Ringel/ESP32Controller/esp32controller.kicad_pcb

## KiCad design esp32controller.kicad_pcb (2019-06-16)

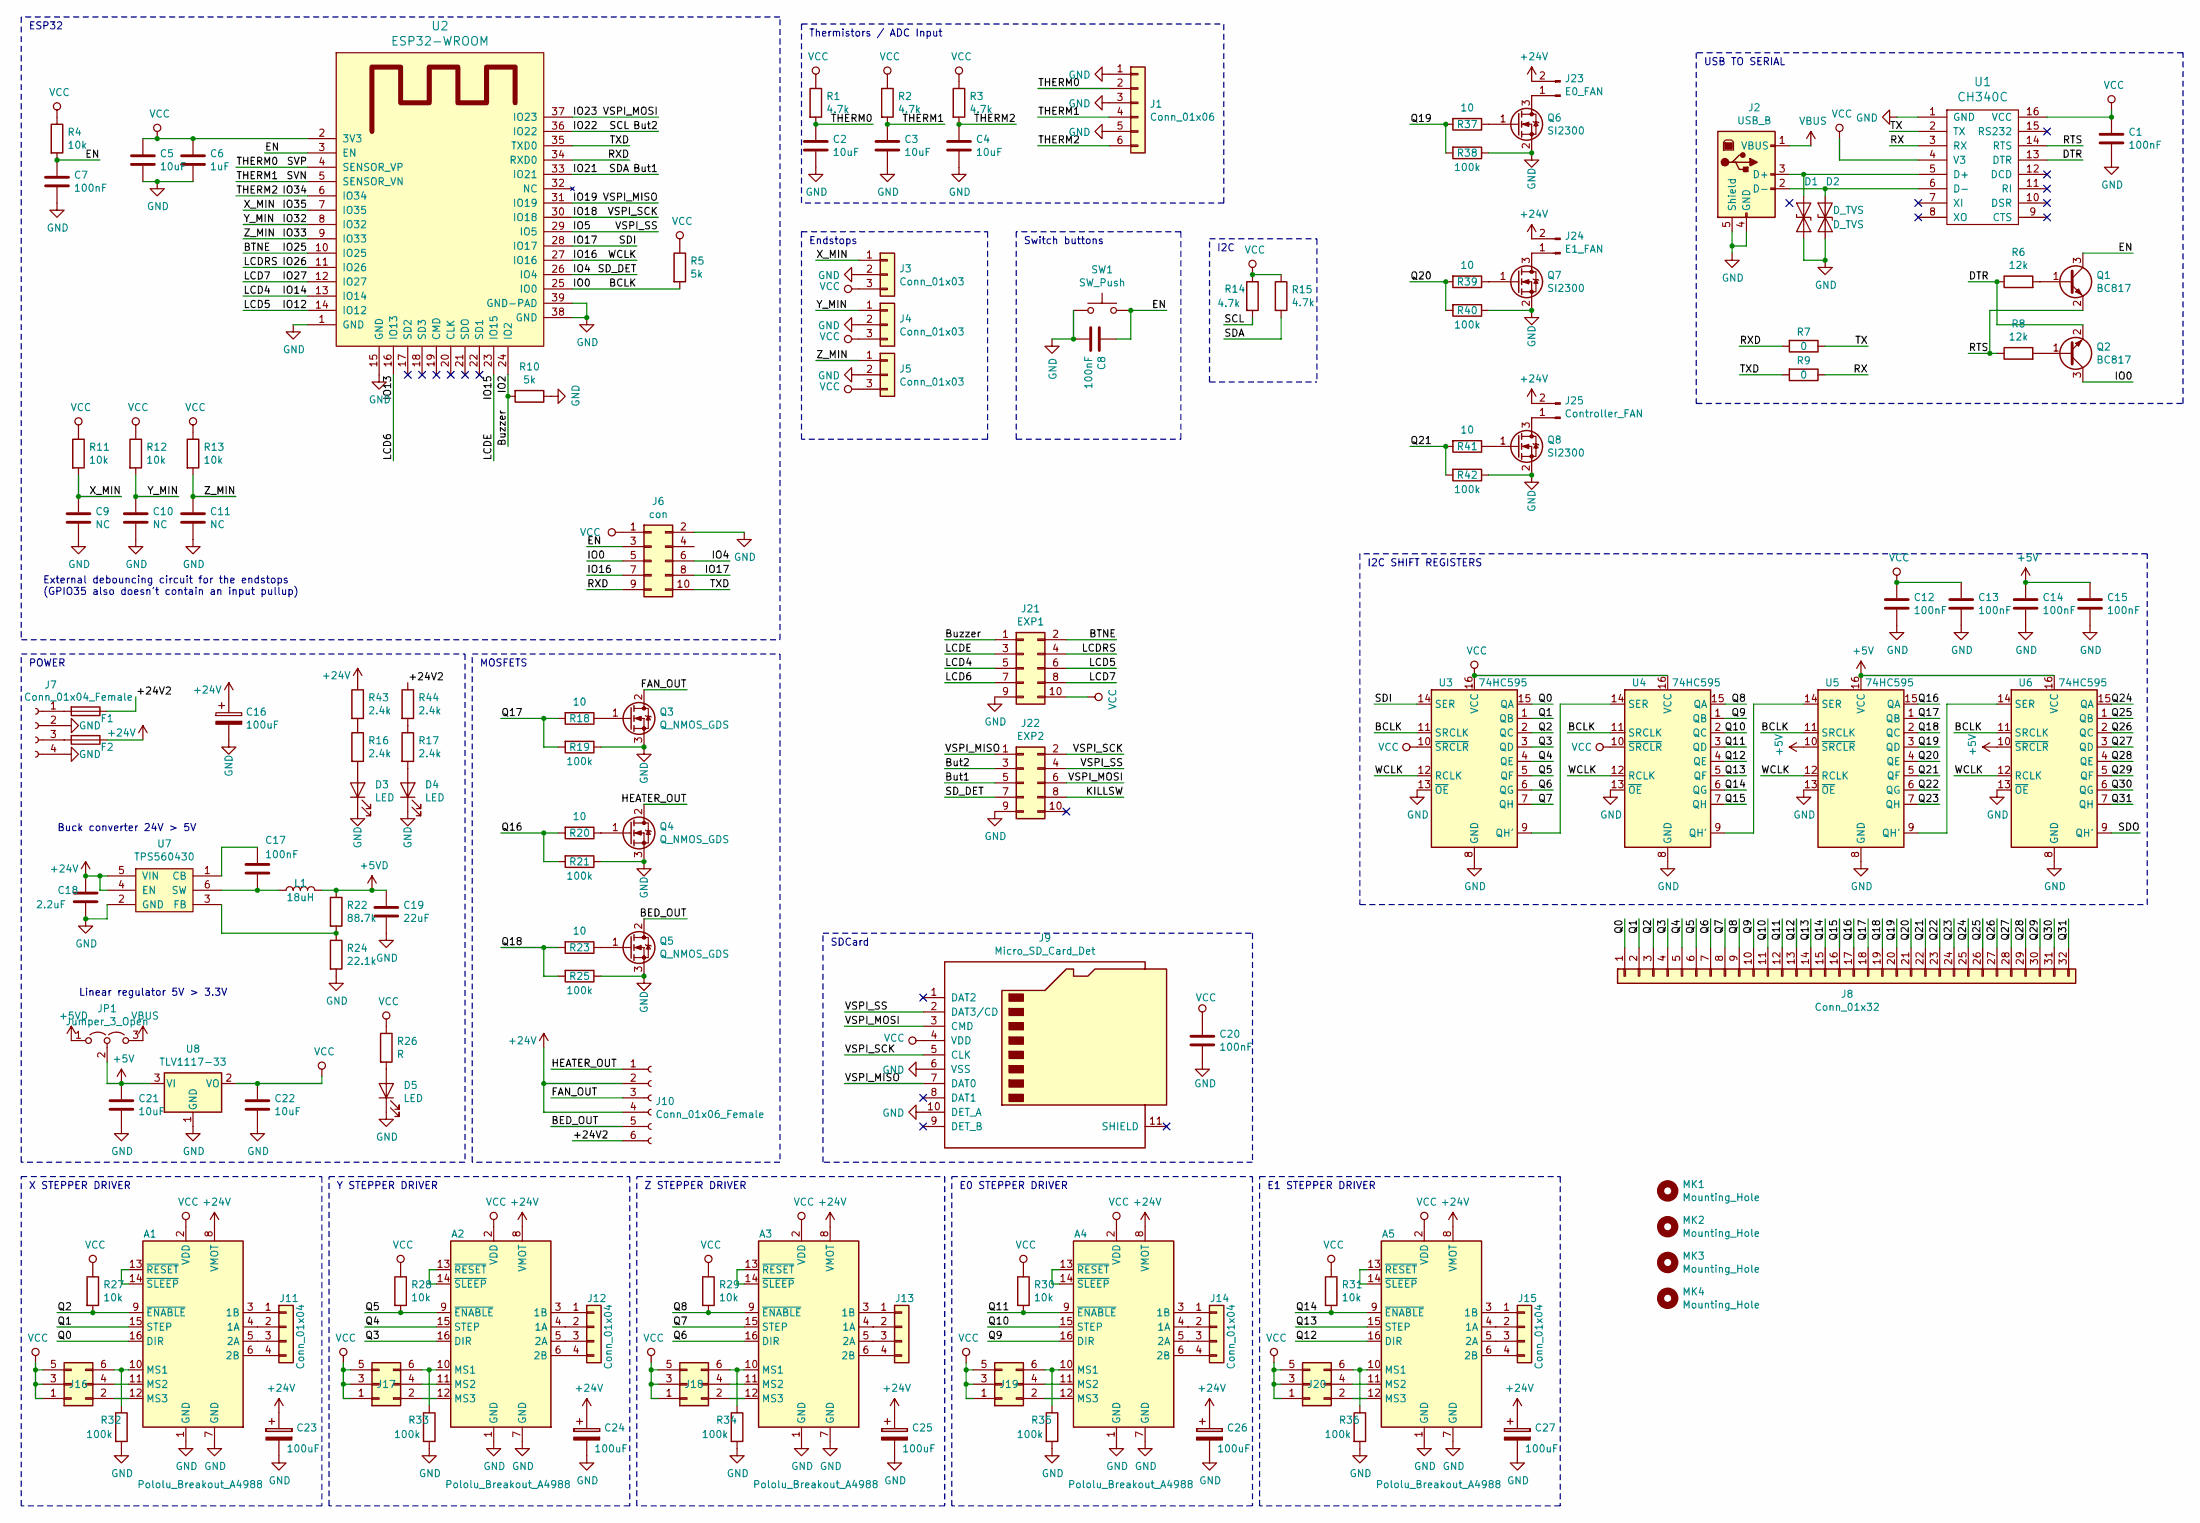
[picture p1: schematic esp32controller.sch]

Parts:
A1, A2, A3, A4, A5: Pololu_Breakout_A4988; Pololu_Breakout-16_15.2x20.3mm
C1, C7, C8, C12, C13, C14, C15, C17, C20: 100nF; C_0805_2012Metric
C2, C3, C4, C5, C21, C22: 10uF; C_0805_2012Metric
C6: 1uF; C_0805_2012Metric
C9, C10, C11: NC; C_0805_2012Metric
C16, C23, C24, C25, C26, C27: 100uF; CP_Elec_6.3x7.7
C18: 2.2uF; C_0805_2012Metric
C19: 22uF; C_0805_2012Metric
D1, D2: D_TVS; D_0603_1608Metric
D3, D4, D5: LED; LED_0805_2012Metric
F1, F2: Fuse; Fuse_0679H
J1: Conn_01x06; PinHeader_2x03_P2.54mm_Vertical
J2: USB_B; USB_B_OST_USB-B1HSxx_Horizontal
J3, J4, J5: Conn_01x03; PinHeader_1x03_P2.54mm_Vertical
J6: con; PinHeader_2x05_P2.54mm_Vertical
J7: Conn_01x04_Female; KP7.62x4
J8: Conn_01x32; PinHeader_2x16_P2.54mm_Vertical
J9: Micro_SD_Card_Det; microsd
J10: Conn_01x06_Female; KP7.62x6
J11, J12, J13, J14, J15: Conn_01x04; Socket_Strip_Straight_1x04_Pitch2.54mm_dual
J16, J17, J18, J19, J20: Conn_02x03_Odd_Even; PinHeader_2x03_P2.54mm_Vertical
J21: EXP1; PinHeader_2x05_P2.54mm_Vertical
J22: EXP2; PinHeader_2x05_P2.54mm_Vertical
J23: E0_FAN; PinHeader_1x02_P2.54mm_Vertical
J24: E1_FAN; PinHeader_1x02_P2.54mm_Vertical
J25: Controller_FAN; PinHeader_1x02_P2.54mm_Vertical
JP1: Jumper_3_Open; PinHeader_1x03_P2.54mm_Vertical
L1: 18uH; SDR0403
MK1, MK2, MK3, MK4: Mounting_Hole; MountingHole_3.2mm_M3
Q1, Q2: BC817; SOT-23
Q3, Q4, Q5: Q_NMOS_GDS; TO-252-2
Q6, Q7, Q8: SI2300; SOT-23
R1, R2, R3, R14, R15: 4.7k; R_0805_2012Metric
R4, R11, R12, R13, R27, R28, R29, R30, R31: 10k; R_0805_2012Metric
R5, R10: 5k; R_0805_2012Metric
R6, R8: 12k; R_0805_2012Metric
R7, R9: 0; R_0805_2012Metric
R16, R17, R43, R44: 2.4k; R_0805_2012Metric
R18, R20, R23, R37, R39, R41: 10; R_0805_2012Metric
R19, R21, R25, R32, R33, R34, R35, R36, R38, R40, R42: 100k; R_0805_2012Metric
R22: 88.7k; R_0805_2012Metric
R24: 22.1k; R_0805_2012Metric
R26: R; R_0805_2012Metric
SW1: SW_Push; SW_Push_1P1T_NO_6x6mm_H9.5mm
U1: CH340C; SOP-16_4.4x10.4mm_P1.27mm
U2: ESP32-WROOM
U3, U4, U5, U6: 74HC595; TSSOP-16_4.4x5mm_P0.65mm
U7: TPS560430; SOT-23-6
U8: TLV1117-33; SOT-223-3_TabPin2

Connections:
+5V: C14.1, C15.1, C21.1, JP1.2 (C), U5.10 (~SRCLR), U5.16 (VCC), U6.10 (~SRCLR), U6.16 (VCC), U8.3 (VI)
+5VD: C19.1, JP1.1 (A), L1.2, R22.1
+24V: A1.8 (VMOT), A2.8 (VMOT), A3.8 (VMOT), A4.8 (VMOT), A5.8 (VMOT), C16.1, C18.1, C23.1, C24.1, C25.1, C26.1, C27.1, F2.1, J10.2, J10.4, J23.2, J24.2, J25.2, R43.1, U7.4 (EN), U7.5 (VIN)
/+24V2: F1.1, J10.6, R44.1
/BCLK: J6.5, Q2.3 (C), R5.2, U2.25 (IO0), U3.11 (SRCLK), U4.11 (SRCLK), U5.11 (SRCLK), U6.11 (SRCLK)
/BED_OUT: J10.5, Q5.2 (D)
/BTNE: J21.2, U2.10 (IO25)
/But1: J22.5, R15.2, U2.33 (IO21)
/But2: J22.3, R14.2, U2.36 (IO22)
/Buzzer: J21.1, R10.2, U2.24 (IO2)
/DTR: Q2.2 (E), R6.1, U1.13 (DTR)
/EN: C7.1, C8.1, J6.3, Q1.3 (C), R4.2, SW1.2, U2.3 (EN)
/FAN_OUT: J10.3, Q3.2 (D)
/HEATER_OUT: J10.1, Q4.2 (D)
/IO4: J6.6, J22.7, U2.26 (IO4)
/IO5: J9.2 (DAT3/CD), J22.4, U2.29 (IO5)
/IO12: J21.6, U2.14 (IO12)
/IO13: J21.7, U2.16 (IO13)
/IO14: J21.5, U2.13 (IO14)
/IO15: J21.3, U2.23 (IO15)
/IO16: J6.7, U2.27 (IO16), U3.12 (RCLK), U4.12 (RCLK), U5.12 (RCLK), U6.12 (RCLK)
/IO17: J6.8, U2.28 (IO17), U3.14 (SER)
/IO18: J9.5 (CLK), J22.2, U2.30 (IO18)
/IO19: J9.7 (DAT0), J22.1, U2.31 (IO19)
/IO23: J9.3 (CMD), J22.6, U2.37 (IO23)
/IO26: J21.4, U2.11 (IO26)
/IO27: J21.8, U2.12 (IO27)
/IO32: C10.1, J4.1, R12.2, U2.8 (IO32)
/IO33: C11.1, J5.1, R13.2, U2.9 (IO33)
/IO34: C4.1, J1.6, R3.2, U2.6 (IO34)
/IO35: C9.1, J3.1, R11.2, U2.7 (IO35)
/Q0: A1.16 (DIR), J8.1, U3.15 (QA)
/Q1: A1.15 (STEP), J8.2, U3.1 (QB)
/Q2: A1.9 (~ENABLE), J8.3, R27.2, U3.2 (QC)
/Q3: A2.16 (DIR), J8.4, U3.3 (QD)
/Q4: A2.15 (STEP), J8.5, U3.4 (QE)
/Q5: A2.9 (~ENABLE), J8.6, R28.2, U3.5 (QF)
/Q6: A3.16 (DIR), J8.7, U3.6 (QG)
/Q7: A3.15 (STEP), J8.8, U3.7 (QH)
/Q8: A3.9 (~ENABLE), J8.9, R29.2, U4.15 (QA)
/Q9: A4.16 (DIR), J8.10, U4.1 (QB)
/Q10: A4.15 (STEP), J8.11, U4.2 (QC)
/Q11: A4.9 (~ENABLE), J8.12, R30.2, U4.3 (QD)
/Q12: A5.16 (DIR), J8.13, U4.4 (QE)
/Q13: A5.15 (STEP), J8.14, U4.5 (QF)
/Q14: A5.9 (~ENABLE), J8.15, R31.2, U4.6 (QG)
/Q15: J8.16, U4.7 (QH)
/Q16: J8.17, R20.2, R21.2, U5.15 (QA)
/Q17: J8.18, R18.2, R19.2, U5.1 (QB)
/Q18: J8.19, R23.2, R25.2, U5.2 (QC)
/Q19: J8.20, R37.2, R38.2, U5.3 (QD)
/Q20: J8.21, R39.2, R40.2, U5.4 (QE)
/Q21: J8.22, R41.2, R42.2, U5.5 (QF)
/Q22: J8.23, U5.6 (QG)
/Q23: J8.24, U5.7 (QH)
/Q24: J8.25, U6.15 (QA)
/Q25: J8.26, U6.1 (QB)
/Q26: J8.27, U6.2 (QC)
/Q27: J8.28, U6.3 (QD)
/Q28: J8.29, U6.4 (QE)
/Q29: J8.30, U6.5 (QF)
/Q30: J8.31, U6.6 (QG)
/Q31: J8.32, U6.7 (QH)
/RTS: Q1.2 (E), R8.1, U1.14 (RTS)
/RX: R9.1, U1.3 (RX)
/RXD: J6.9, R7.2, U2.34 (RXD0)
/SVN: C3.1, J1.4, R2.2, U2.5 (SENSOR_VN)
/SVP: C2.1, J1.2, R1.2, U2.4 (SENSOR_VP)
/TX: R7.1, U1.2 (TX)
/TXD: J6.10, R9.2, U2.35 (TXD0)
GND: A1.1 (GND), A1.7 (GND), A2.1 (GND), A2.7 (GND), A3.1 (GND), A3.7 (GND), A4.1 (GND), A4.7 (GND), A5.1 (GND), A5.7 (GND), C1.2, C2.2, C3.2, C4.2, C5.2, C6.2, C7.2, C8.2, C9.2, C10.2, C11.2, C12.2, C13.2, C14.2, C15.2, C16.2, C18.2, C19.2, C20.2, C21.2, C22.2, C23.2, C24.2, C25.2, C26.2, C27.2, D1.2 (A2), D2.2 (A2), D3.1 (K), D4.1 (K), D5.1 (K), J1.1, J1.3, J1.5, J2.4 (GND), J2.5 (Shield), J3.2, J4.2, J5.2, J6.2, J7.2, J7.4, J9.6 (VSS), J9.10 (DET_A), J21.9, J22.9, Q3.3 (S), Q4.3 (S), Q5.3 (S), Q6.2 (S), Q7.2 (S), Q8.2 (S), R10.1, R19.1, R21.1, R24.2, R25.1, R32.2, R33.2, R34.2, R35.2, R36.2, R38.1, R40.1, R42.1, SW1.1, U1.1 (GND), U2.1 (GND), U2.15 (GND), U2.38 (GND), U2.39 (GND-PAD), U3.8 (GND), U3.13 (~OE), U4.8 (GND), U4.13 (~OE), U5.8 (GND), U5.13 (~OE), U6.8 (GND), U6.13 (~OE), U7.2 (GND), U8.1 (GND)
unnamed: A1.3 (1B), J11.1
unnamed: A1.4 (1A), J11.2
unnamed: A1.5 (2A), J11.3
unnamed: A1.6 (2B), J11.4
unnamed: A1.10 (MS1), J16.6, R32.1
unnamed: A1.11 (MS2), J16.4
unnamed: A1.12 (MS3), J16.2
unnamed: A1.13 (~RESET), A1.14 (~SLEEP)
unnamed: A2.3 (1B), J12.1
unnamed: A2.4 (1A), J12.2
unnamed: A2.5 (2A), J12.3
unnamed: A2.6 (2B), J12.4
unnamed: A2.10 (MS1), J17.6, R33.1
unnamed: A2.11 (MS2), J17.4
unnamed: A2.12 (MS3), J17.2
unnamed: A2.13 (~RESET), A2.14 (~SLEEP)
unnamed: A3.3 (1B), J13.1
unnamed: A3.4 (1A), J13.2
unnamed: A3.5 (2A), J13.3
unnamed: A3.6 (2B), J13.4
unnamed: A3.10 (MS1), J18.6, R34.1
unnamed: A3.11 (MS2), J18.4
unnamed: A3.12 (MS3), J18.2
unnamed: A3.13 (~RESET), A3.14 (~SLEEP)
unnamed: A4.3 (1B), J14.1
unnamed: A4.4 (1A), J14.2
unnamed: A4.5 (2A), J14.3
unnamed: A4.6 (2B), J14.4
unnamed: A4.10 (MS1), J19.6, R35.1
unnamed: A4.11 (MS2), J19.4
unnamed: A4.12 (MS3), J19.2
unnamed: A4.13 (~RESET), A4.14 (~SLEEP)
unnamed: A5.3 (1B), J15.1
unnamed: A5.4 (1A), J15.2
unnamed: A5.5 (2A), J15.3
unnamed: A5.6 (2B), J15.4
unnamed: A5.10 (MS1), J20.6, R36.1
unnamed: A5.11 (MS2), J20.4
unnamed: A5.12 (MS3), J20.2
unnamed: A5.13 (~RESET), A5.14 (~SLEEP)
unnamed: C17.1, U7.1 (CB)
unnamed: C17.2, L1.1, U7.6 (SW)
unnamed: D1.1 (A1), J2.3 (D+), U1.5 (D+)
unnamed: D2.1 (A1), J2.2 (D-), U1.6 (D-)
unnamed: D3.2 (A), R16.2
unnamed: D4.2 (A), R17.2
unnamed: D5.2 (A), R26.2
unnamed: F1.2, J7.1
unnamed: F2.2, J7.3
unnamed: J23.1, Q6.3 (D)
unnamed: J24.1, Q7.3 (D)
unnamed: J25.1, Q8.3 (D)
unnamed: Q1.1 (B), R6.2
unnamed: Q2.1 (B), R8.2
unnamed: Q3.1 (G), R18.1
unnamed: Q4.1 (G), R20.1
unnamed: Q5.1 (G), R23.1
unnamed: Q6.1 (G), R37.1
unnamed: Q7.1 (G), R39.1
unnamed: Q8.1 (G), R41.1
unnamed: R16.1, R43.2
unnamed: R17.1, R44.2
unnamed: R22.2, R24.1, U7.3 (FB)
unnamed: U3.9 (QH'), U4.14 (SER)
unnamed: U4.9 (QH'), U5.14 (SER)
unnamed: U5.9 (QH'), U6.14 (SER)
VBUS: J2.1 (VBUS), JP1.3 (B)
VCC: A1.2 (VDD), A2.2 (VDD), A3.2 (VDD), A4.2 (VDD), A5.2 (VDD), C1.1, C5.1, C6.1, C12.1, C13.1, C20.1, C22.1, J3.3, J4.3, J5.3, J6.1, J9.4 (VDD), J16.1, J16.3, J16.5, J17.1, J17.3, J17.5, J18.1, J18.3, J18.5, J19.1, J19.3, J19.5, J20.1, J20.3, J20.5, J21.10, R1.1, R2.1, R3.1, R4.1, R5.1, R11.1, R12.1, R13.1, R14.1, R15.1, R26.1, R27.1, R28.1, R29.1, R30.1, R31.1, U1.4 (V3), U1.16 (VCC), U2.2 (3V3), U3.10 (~SRCLR), U3.16 (VCC), U4.10 (~SRCLR), U4.16 (VCC), U8.2 (VO)

Notes on the sheet:
X STEPPER DRIVER
Y STEPPER DRIVER
Z STEPPER DRIVER
E0 STEPPER DRIVER
I2C
Thermistors / ADC Input
Endstops
USB TO SERIAL
SDCard
Buck converter 24V > 5V
Linear regulator 5V > 3.3V
POWER
MOSFETS
ESP32
E1 STEPPER DRIVER
External debouncing circuit for the endstops (GPIO35 also doesn't contain an input pullup)
I2C SHIFT REGISTERS
Switch buttons

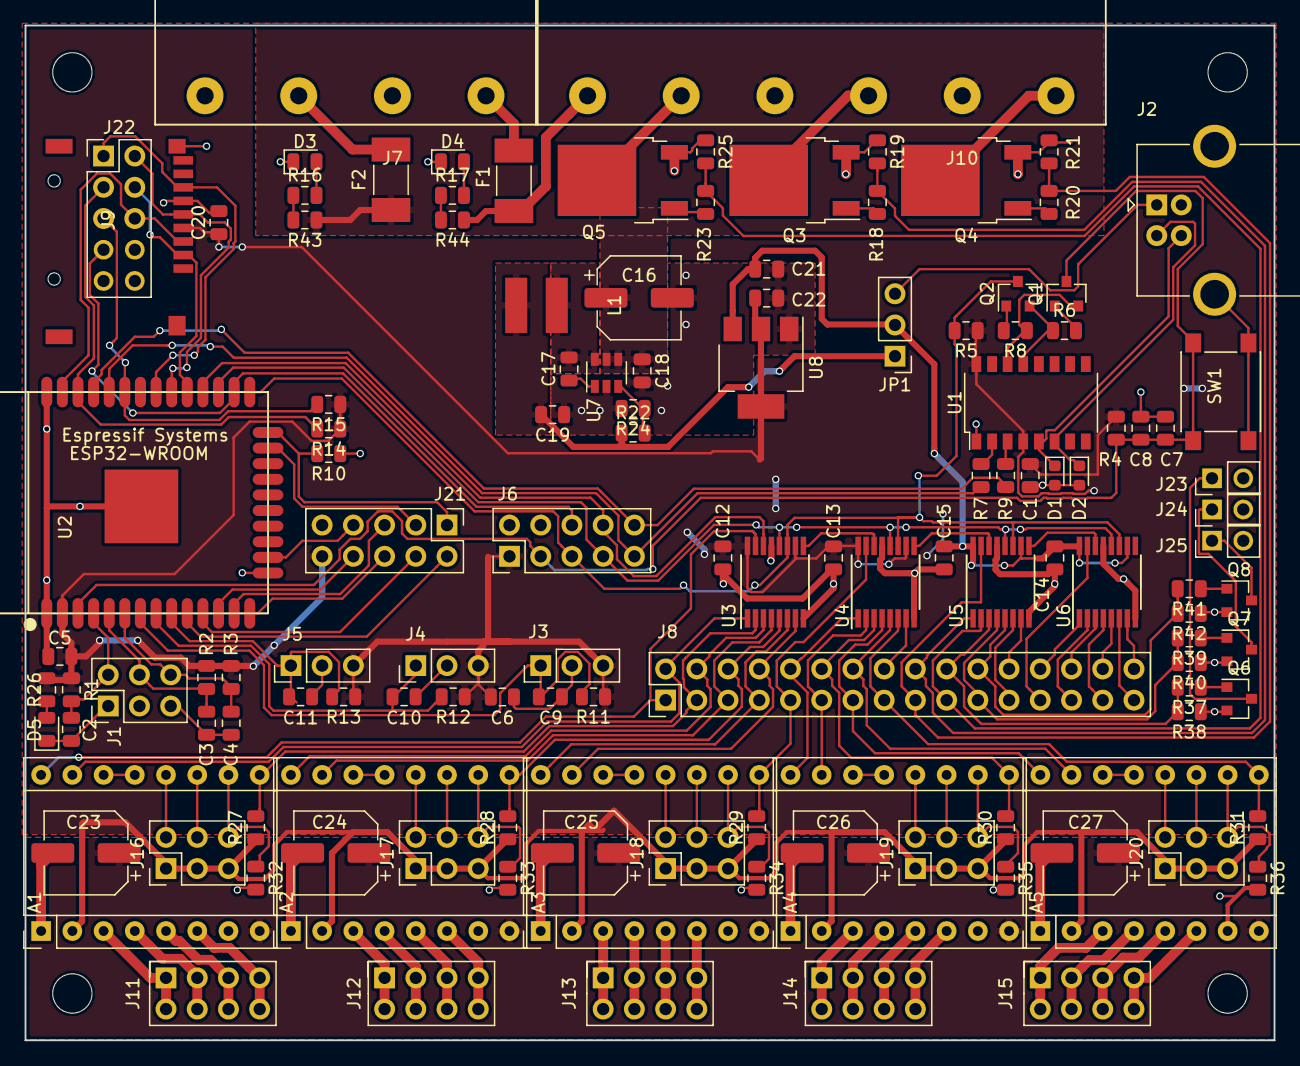
[picture p2: board esp32controller.kicad_pcb from above]

Board: 2 copper layers, 101.6 x 82.6 mm, 131 parts (0 on the bottom side), 139 nets.
