Ringel/ESP32Controller/(commit log)

2019-06-16 Shuffled pins, added Display Connector and more FETs, Supplied Shiftregister with 5V for higher Gate Drive voltage
    [esp32controller.sch]
2019-06-16 Routed R3 Board
    [esp32controller.kicad_pcb]
